AlfredoSystems/NoU2-Hardware/README.md

# NoU2-Hardware
KiCAD files for the Alfredo Systems NoU2. Learn more here:
https://www.alfredosys.com/products/alfredo-nou2/

<p align="">

</p>
