AlfredoSystems/NoU2-Hardware/NoU2-schematic.pdf

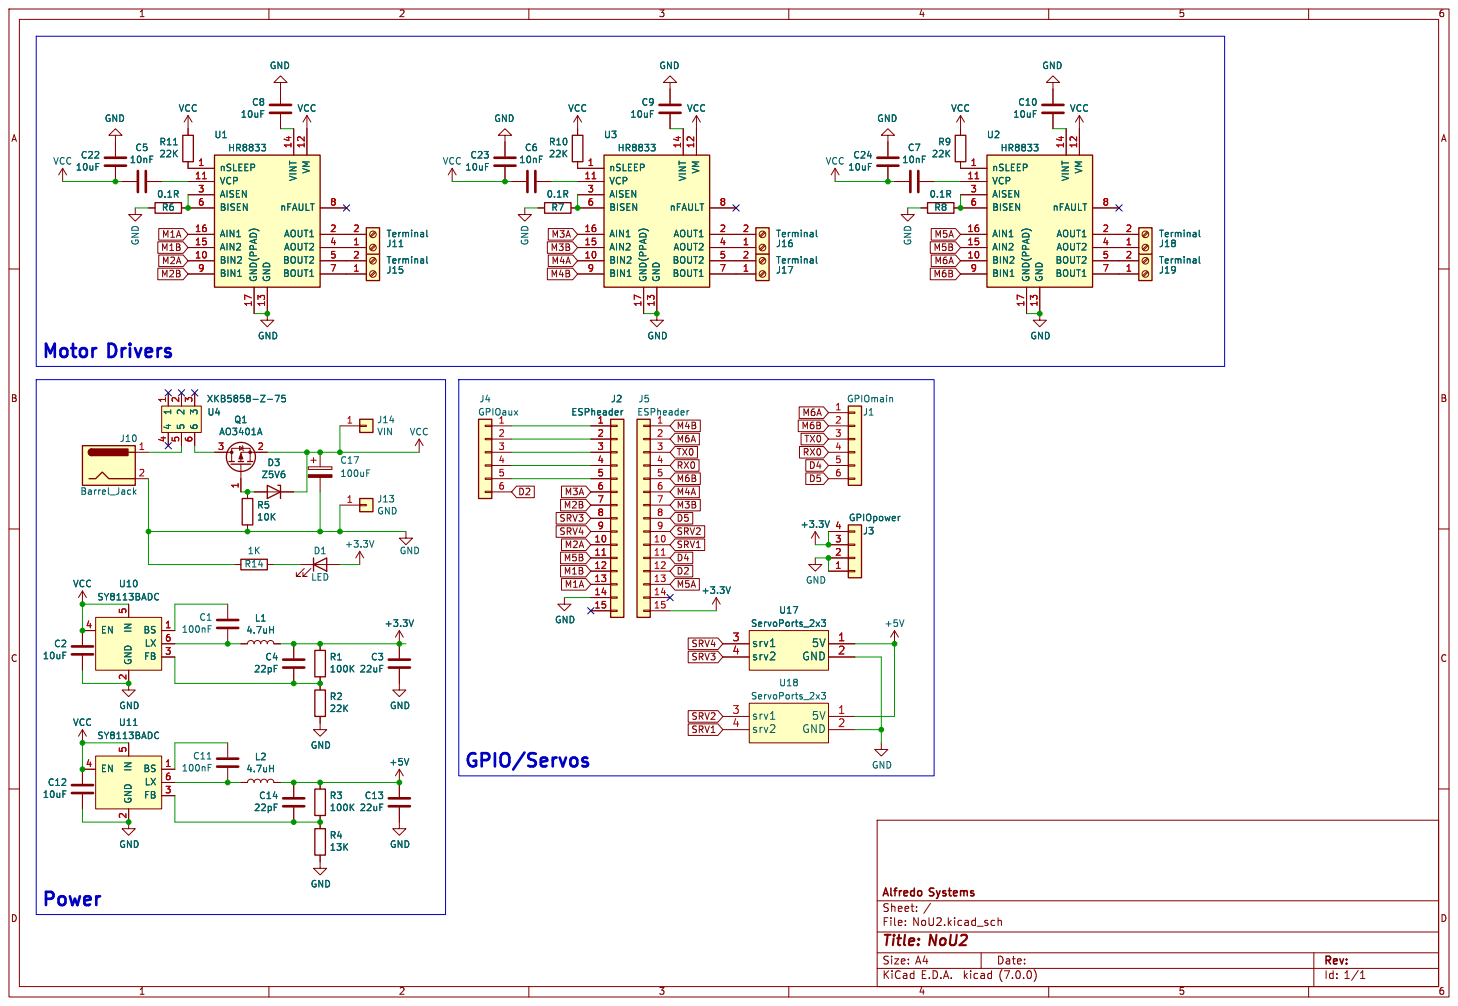
[picture p1: page 1]

File: NoU2.kicad_sch Sheet: / Alfredo Systems R4
