AlfredoSystems/NoU2-Hardware/(commit log)

2022-05-10 The NoU2 as ordered for V2.6.7
    [ESP32DevKitV1.kicad_sch, NoU2.kicad_pcb, NoU2.kicad_sch]
2022-06-03 NoU2 V2.6.7 KiCAD 6 save before next revision
    [NoU2.kicad_sch]
2022-06-05 First version of V2.7.8, includes motor driver changed to HR8833
    [NoU2.kicad_pcb, NoU2.kicad_sch]
2022-06-05 fixed silkscreen
    [NoU2.kicad_pcb, NoU2.kicad_sch]
2022-06-07 NoU2.6.8 to be ordered (unpanelized)
    [NoU2-CuBottom.gbr, NoU2-CuTop.gbr, NoU2-EdgeCuts.gbr, NoU2-MaskBottom.gbr, NoU2-MaskTop.gbr, NoU2-NPTH.drl, NoU2-PTH.drl, NoU2-PasteBottom.gbr]
2022-06-07 NoU2.6.8 ordered prototype (panelized 2x1)
    [NoU2-panelized-CuBottom.gbr, NoU2-panelized-CuTop.gbr, NoU2-panelized-EdgeCuts.gbr, NoU2-panelized-MaskBottom.gbr, NoU2-panelized-MaskTop.gbr, NoU2-panelized-NPTH.drl, NoU2-panelized-PTH.drl, NoU2-panelized-PasteBottom.gbr]
2022-08-28 panelized board and gerber files generated
    [NoU2-panelized-CuTop.gbr, NoU2-panelized-EdgeCuts.gbr, NoU2-panelized-MaskBottom.gbr, NoU2-panelized-MaskTop.gbr, NoU2-panelized-NPTH.drl, NoU2-panelized-PTH.drl, NoU2-panelized-PasteBottom.gbr, NoU2-panelized-PasteTop.gbr]
2023-06-11 major changes are done before panalizing
    [NoU2.kicad_pcb, NoU2.kicad_sch]
2023-06-11 Board as ordered on 4/15
    boards as ordered 4-15-23. MAJOR ISSUE: 0.1R shunt resistors have wrong part.
    [NoU2-panelized-CuTop.gbr, NoU2-panelized-EdgeCuts.gbr, NoU2-panelized-MaskBottom.gbr, NoU2-panelized-MaskTop.gbr, NoU2-panelized-NPTH.drl, NoU2-panelized-PTH.drl, NoU2-panelized-PasteBottom.gbr, NoU2-panelized-PasteTop.gbr]
2023-06-11 fixed 0.1R resistor
    [NoU2.kicad_sch]
2023-06-11 generated 4x5 panel for NoU V2.9.1
    [NoU2-CuBottom.gbr, NoU2-CuTop.gbr, NoU2-EdgeCuts.gbr, NoU2-MaskBottom.gbr, NoU2-MaskTop.gbr, NoU2-NPTH.drl, NoU2-PTH.drl, NoU2-PasteBottom.gbr]
2023-06-11 cleaned up schematic and layout, generated schematic pdf
    [NoU2-panelized2-CuTop.gbr, NoU2-panelized2-EdgeCuts.gbr, NoU2-panelized2-MaskBottom.gbr, NoU2-panelized2-MaskTop.gbr, NoU2-panelized2-NPTH.drl, NoU2-panelized2-PTH.drl, NoU2-panelized2-PasteBottom.gbr, NoU2-panelized2-PasteTop.gbr]
2026-09-29 Update .gitignore and untrack lock files and fab backups
    Ignore KiCad local history (.history/), lock files (*.lck), fab plugin backup zips (production*/backups/) and OS junk. Fix the #auto_saved_files# rule, which git was reading as a comment.
2026-09-29 Update project file for newer KiCad version
