AlfredoSystems/NoU2-Hardware/(notices)

Notices in the files:
NoU2-panelized/NoU2-panelized.kicad_pcb:
© 2022 Alfredo Systems
NoU2.kicad_pcb:
© 2023 Alfredo Systems
